Tynogc/24V-to-12V-step-down-15A/webench_design_4079392_15_154593080.pdf

## WEBENCH ® Design Report

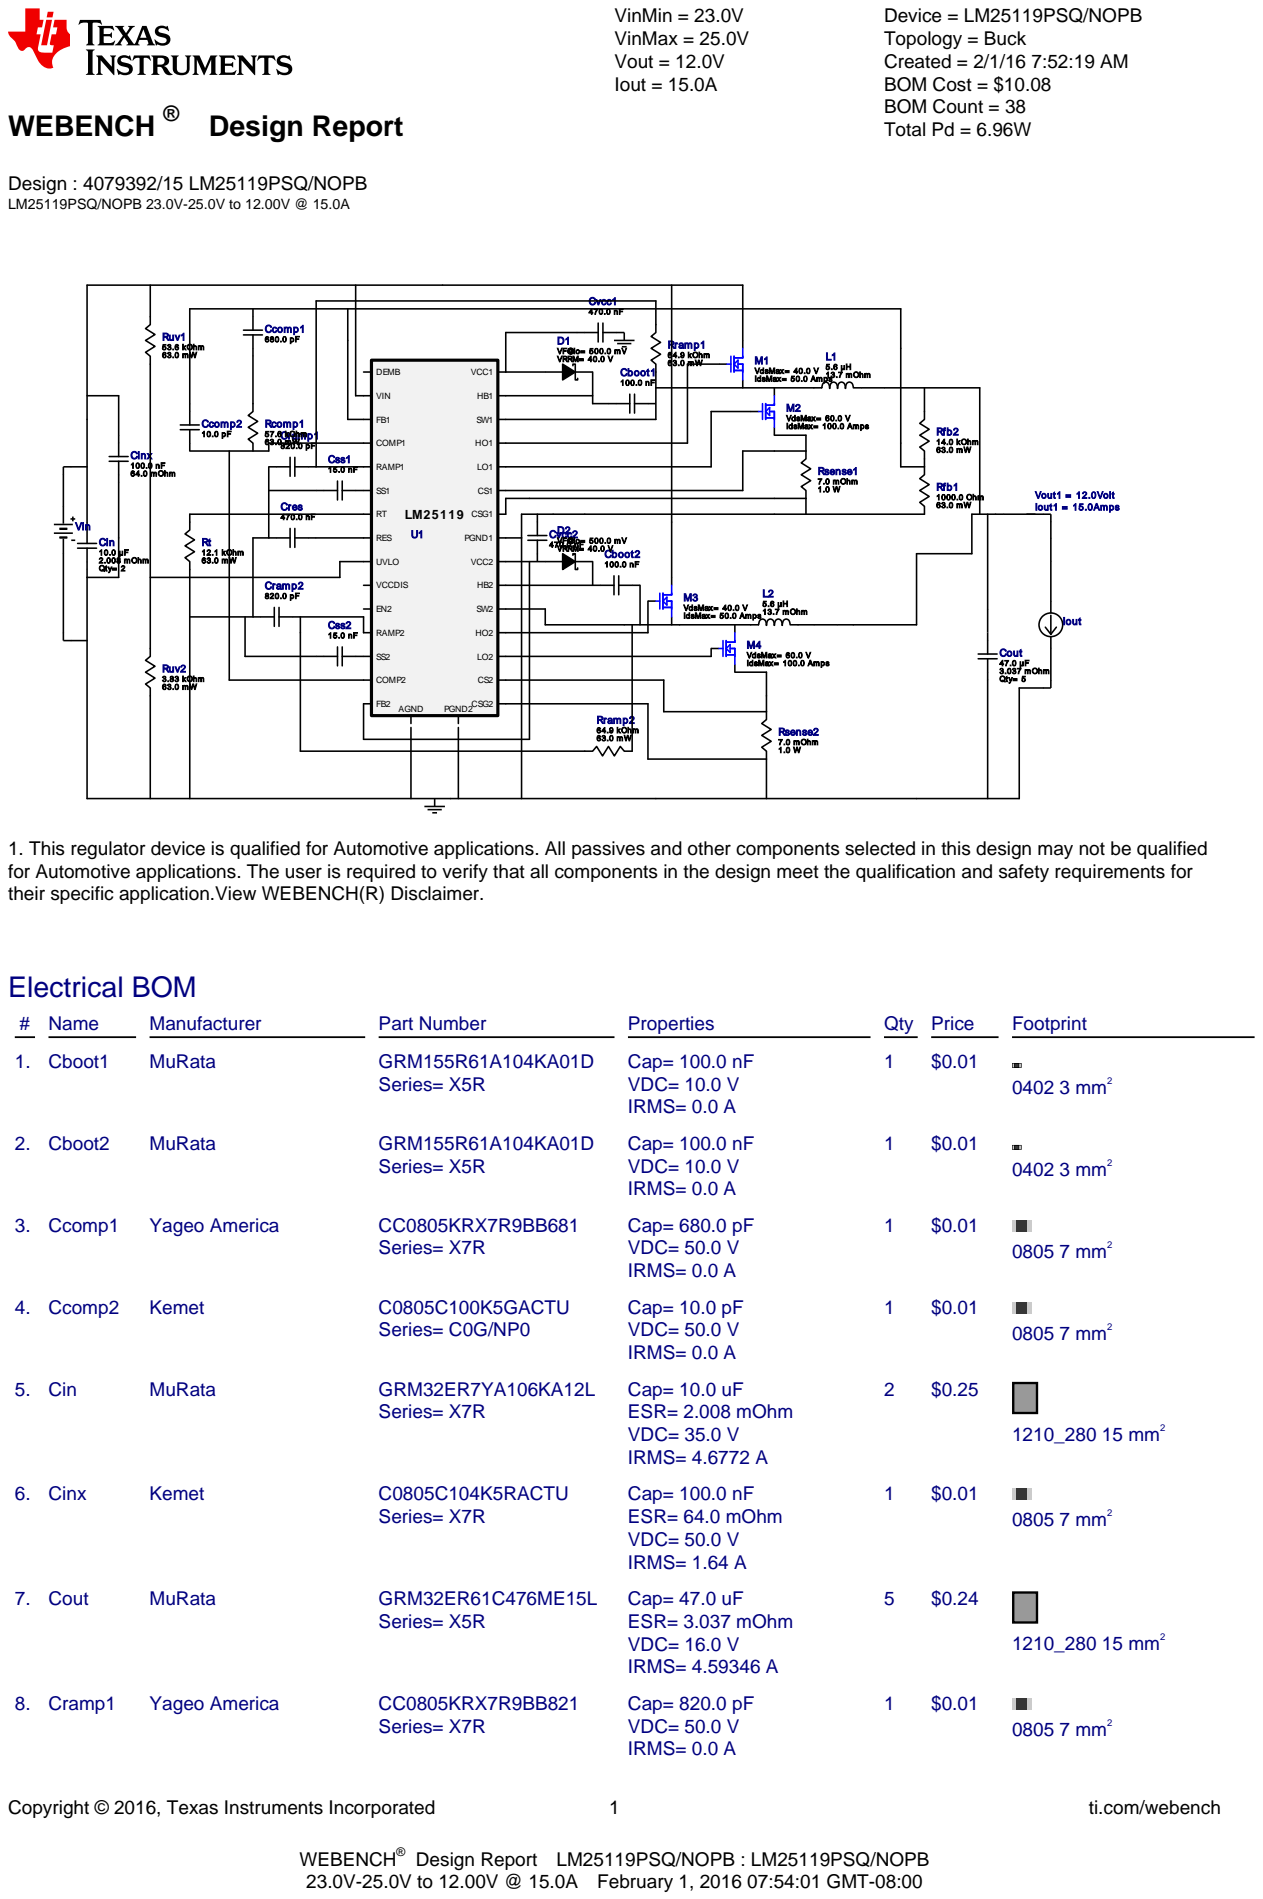
[picture p1: page 1]

1. This regulator device is qualified for Automotive applications. All passives and other components selected in this design may not be qualified
for Automotive applications. The user is required to verify that all components in the design meet the qualification and safety requirements for
their specific application.View WEBENCH(R) Disclaimer.

Design Report LM25119PSQ/NOPB : LM25119PSQ/NOPB

Design

Copyright © 2016, Texas Instruments Incorporated | 2 | ti.com/webench
# Name | Manufacturer | Part Number | Properties | Qty Price | Footprint

9. Cramp2 | Yageo America | CC0805KRX7R9BB821 (http://www.yageo.com/documents/recent/UPY%2DGPHC%5FX7R%5F6.3V%2Dto%2D50V%5F7.pdf) Series= X7R | Cap= 820.0 pF VDC= 50.0 V IRMS= 0.0 A
1 | $0.01
| | | | | 0805 7 mm²
10. Cres | MuRata | GRM155C80J474KE19D (http://search.murata.co.jp/Ceramy/PnsearchViewAction.do) Series= X6S | Cap= 470.0 nF VDC= 6.3 V IRMS= 0.0 A
1 | $0.01
| | | | | 0402 3 mm²
11. Css1 | Yageo America | CC0805KRX7R9BB153 (http://www.yageo.com/documents/recent/UPY%2DGPHC%5FX7R%5F6.3V%2Dto%2D50V%5F7.pdf) Series= X7R | Cap= 15.0 nF VDC= 50.0 V IRMS= 0.0 A
1 | $0.01
| | | | | 0805 7 mm²
12. Css2 | Yageo America | CC0805KRX7R9BB153 (http://www.yageo.com/documents/recent/UPY%2DGPHC%5FX7R%5F6.3V%2Dto%2D50V%5F7.pdf) Series= X7R | Cap= 15.0 nF VDC= 50.0 V IRMS= 0.0 A
1 | $0.01
| | | | | 0805 7 mm²
13. Cvcc1 | MuRata | GRM155R61A474KE15D (http://search.murata.co.jp/Ceramy/PnsearchViewAction.do) Series= X5R | Cap= 470.0 nF VDC= 10.0 V IRMS= 0.0 A
1 | $0.01
| | | | | 0402 3 mm²
14. Cvcc2 | MuRata | GRM155R61A474KE15D (http://search.murata.co.jp/Ceramy/PnsearchViewAction.do) Series= X5R | Cap= 470.0 nF VDC= 10.0 V IRMS= 0.0 A
1 | $0.01
| | | | | 0402 3 mm²
15. D1 | Diodes Inc. | B240A-13-F (http://www.diodes.com/datasheets/ds13004.pdf) | VF@Io= 500.0 mV VRRM= 40.0 V
1 | $0.09
| | | | | SMA 37 mm²
16. D2 | Diodes Inc. | B240A-13-F (http://www.diodes.com/datasheets/ds13004.pdf) | VF@Io= 500.0 mV VRRM= 40.0 V
1 | $0.09
| | | | | SMA 37 mm²
17. L1 | Coilcraft | XAL7070-562MEB (http://www.coilcraft.com/pdfs/xal7070.pdf) | L= 5.6 µH DCR= 13.7 mOhm
1 | $1.05

XAL7070 87 mm²
18. L2 | Coilcraft | XAL7070-562MEB (http://www.coilcraft.com/pdfs/xal7070.pdf) | L= 5.6 µH DCR= 13.7 mOhm
1 | $1.05

XAL7070 87 mm²
19. M1 | Texas Instruments | CSD18504Q5A (http://www.ti.com/lit/ds/symlink/csd18504q5a.pdf) | VdsMax= 40.0 V IdsMax= 50.0 Amps
1 | $0.56

TRANS_NexFET_Q5A 55
mm²
20. M2 | Texas Instruments | CSD18531Q5A (http://www.ti.com/lit/ds/symlink/csd18531q5a.pdf) | VdsMax= 60.0 V IdsMax= 100.0 Amps
1 | $0.90

TRANS_NexFET_Q5A 55
mm²
21. M3 | Texas Instruments | CSD18504Q5A (http://www.ti.com/lit/ds/symlink/csd18504q5a.pdf) | VdsMax= 40.0 V IdsMax= 50.0 Amps
1 | $0.56

TRANS_NexFET_Q5A 55
mm²
22. M4 | Texas Instruments | CSD18531Q5A (http://www.ti.com/lit/ds/symlink/csd18531q5a.pdf) | VdsMax= 60.0 V IdsMax= 100.0 Amps
1 | $0.90

TRANS_NexFET_Q5A 55
mm²
23. Rcomp1 | Vishay-Dale | CRCW040257K6FKED (http://www.vishay.com/docs/20035/dcrcwe3.pdf) Series= CRCW..e3 | Res= 57.6 kOhm Power= 63.0 mW Tolerance= 1.0%
1 | $0.01
0402 3 mm²
24. Rfb1 | Vishay-Dale | CRCW04021K00FKED (http://www.vishay.com/docs/20035/dcrcwe3.pdf) Series= CRCW..e3 | Res= 1000.0 Ohm Power= 63.0 mW Tolerance= 1.0%
1 | $0.01
0402 3 mm²
25. Rfb2 | Vishay-Dale | CRCW040214K0FKED (http://www.vishay.com/docs/20035/dcrcwe3.pdf) Series= CRCW..e3 | Res= 14.0 kOhm Power= 63.0 mW Tolerance= 1.0%
1 | $0.01
0402 3 mm²
26. Rramp1 | Vishay-Dale | CRCW040264K9FKED (http://www.vishay.com/docs/20035/dcrcwe3.pdf) Series= CRCW..e3 | Res= 64.9 kOhm Power= 63.0 mW Tolerance= 1.0%
1 | $0.01
0402 3 mm²

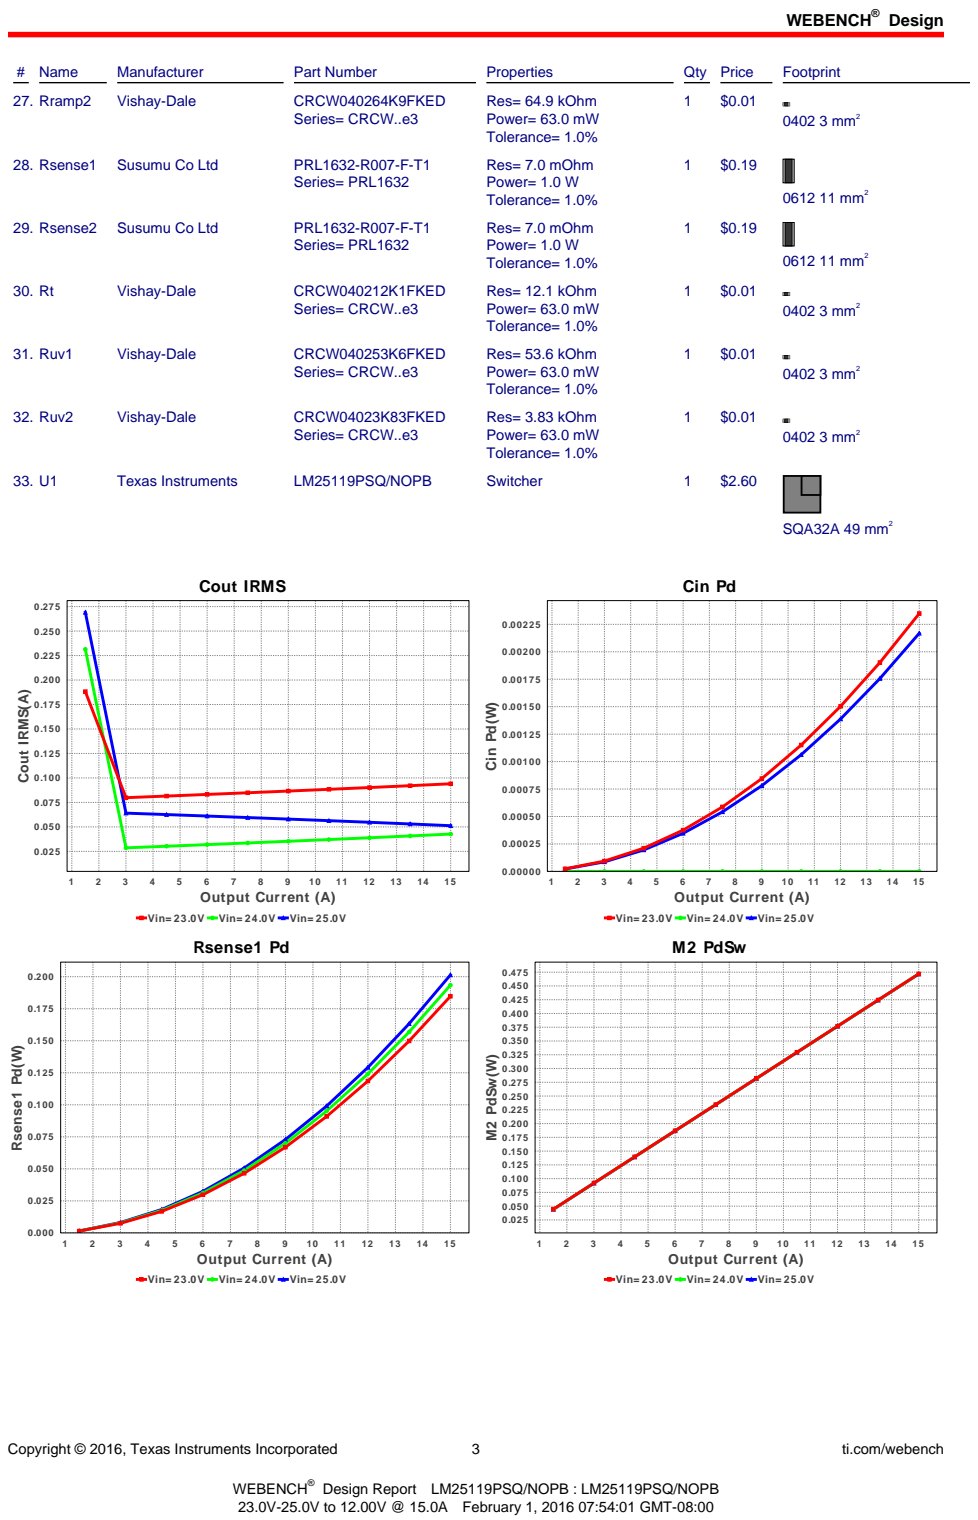
[picture p2: page 3]
Copyright © 2016, Texas Instruments Incorporated; ti.com/webench; # Name; Manufacturer; Part Number; Properties; Qty Price; Footprint; 27. Rramp2; Vishay-Dale; CRCW040264K9FKED; Series= CRCW..e3; Res= 64.9 kOhm Power= 63.0 mW Tolerance= 1.0%; 0402 3 mm²; 28. Rsense1 Susumu Co Ltd; PRL1632-R007-F-T1; Series= PRL1632; Res= 7.0 mOhm Power= 1.0 W Tolerance= 1.0%; 0612 11 mm²; 29. Rsense2 Susumu Co Ltd; CRCW040212K1FKED; Res= 12.1 kOhm Power= 63.0 mW Tolerance= 1.0%; 31. Ruv1; CRCW040253K6FKED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

Vin= 23.0V Vin= 24.0V Vin= 25.0V
Rsense1 Pd

M2 PdSw

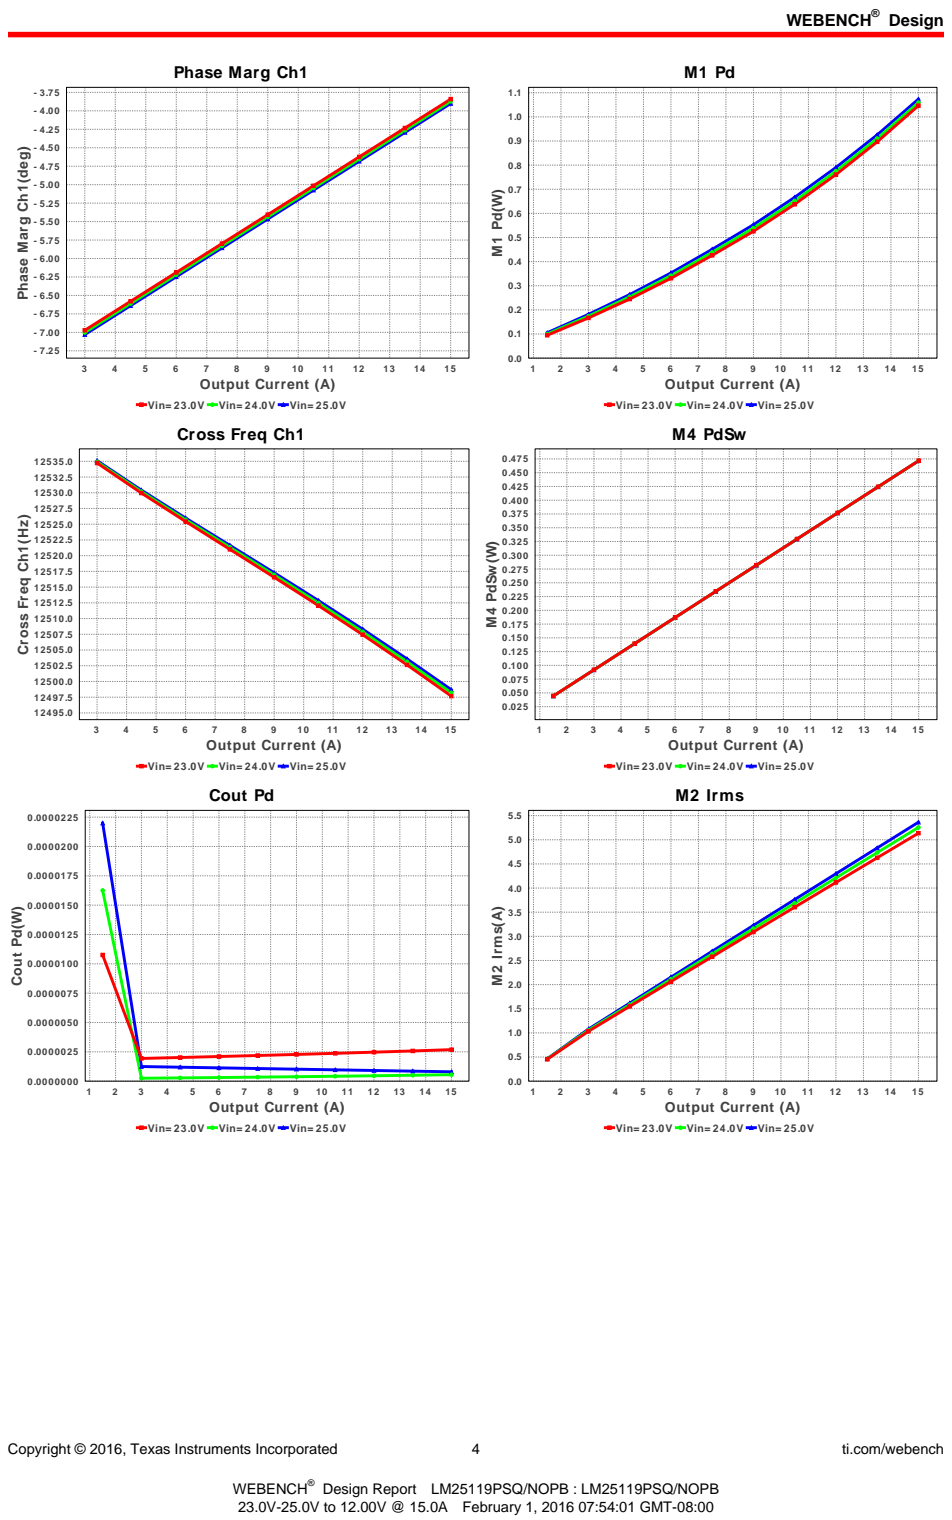
[picture p3: page 4]
Copyright © 2016, Texas Instruments Incorporated; ti.com/webench; Phase Marg Ch1; 15 Output Current (A); M4 PdSw(W); Cout Pd; Cout Pd(W); M2 Irms; M2 Irms(A)

Phase Marg Ch1(deg)

Vin= 23.0V Vin= 24.0V Vin= 25.0V
Cross Freq Ch1

M4 PdSw

Cross Freq Ch1(Hz)

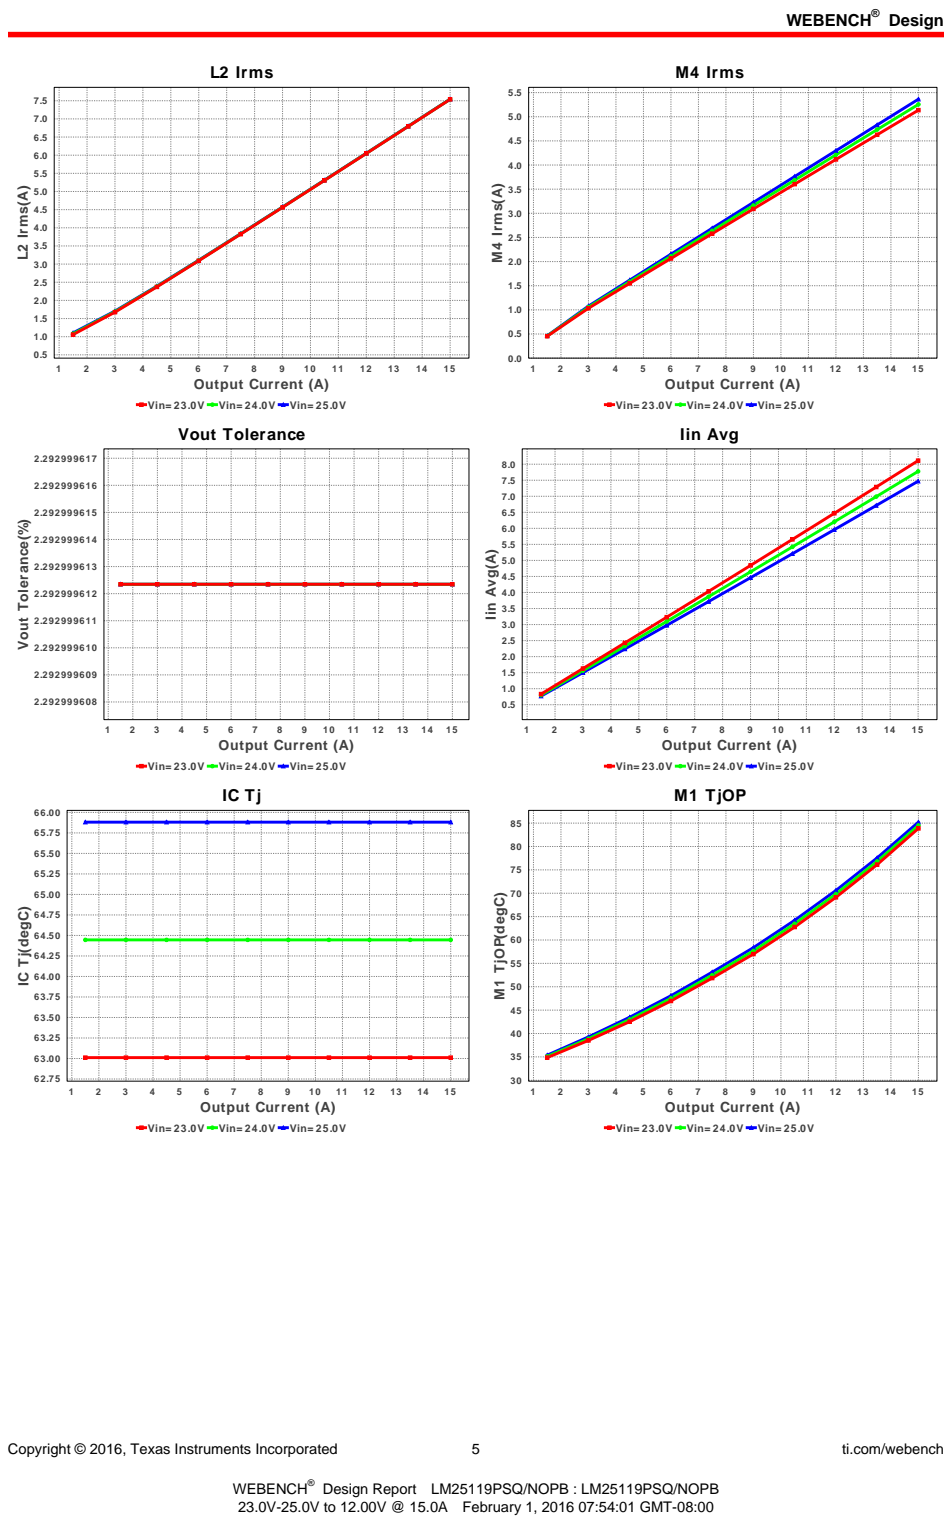
[picture p4: page 5]
Copyright © 2016, Texas Instruments Incorporated; ti.com/webench; L2 Irms; 15 Output Current (A); L2 Irms(A); M4 Irms; M4 Irms(A); 10 11 12 13 14 15 Output Current (A); Vout Tolerance(%); Iin Avg; Iin Avg(A); M1 TjOP; M1 TjOP(degC)

Vin= 23.0V Vin= 24.0V Vin= 25.0V
Vout Tolerance

IC Tj(degC)

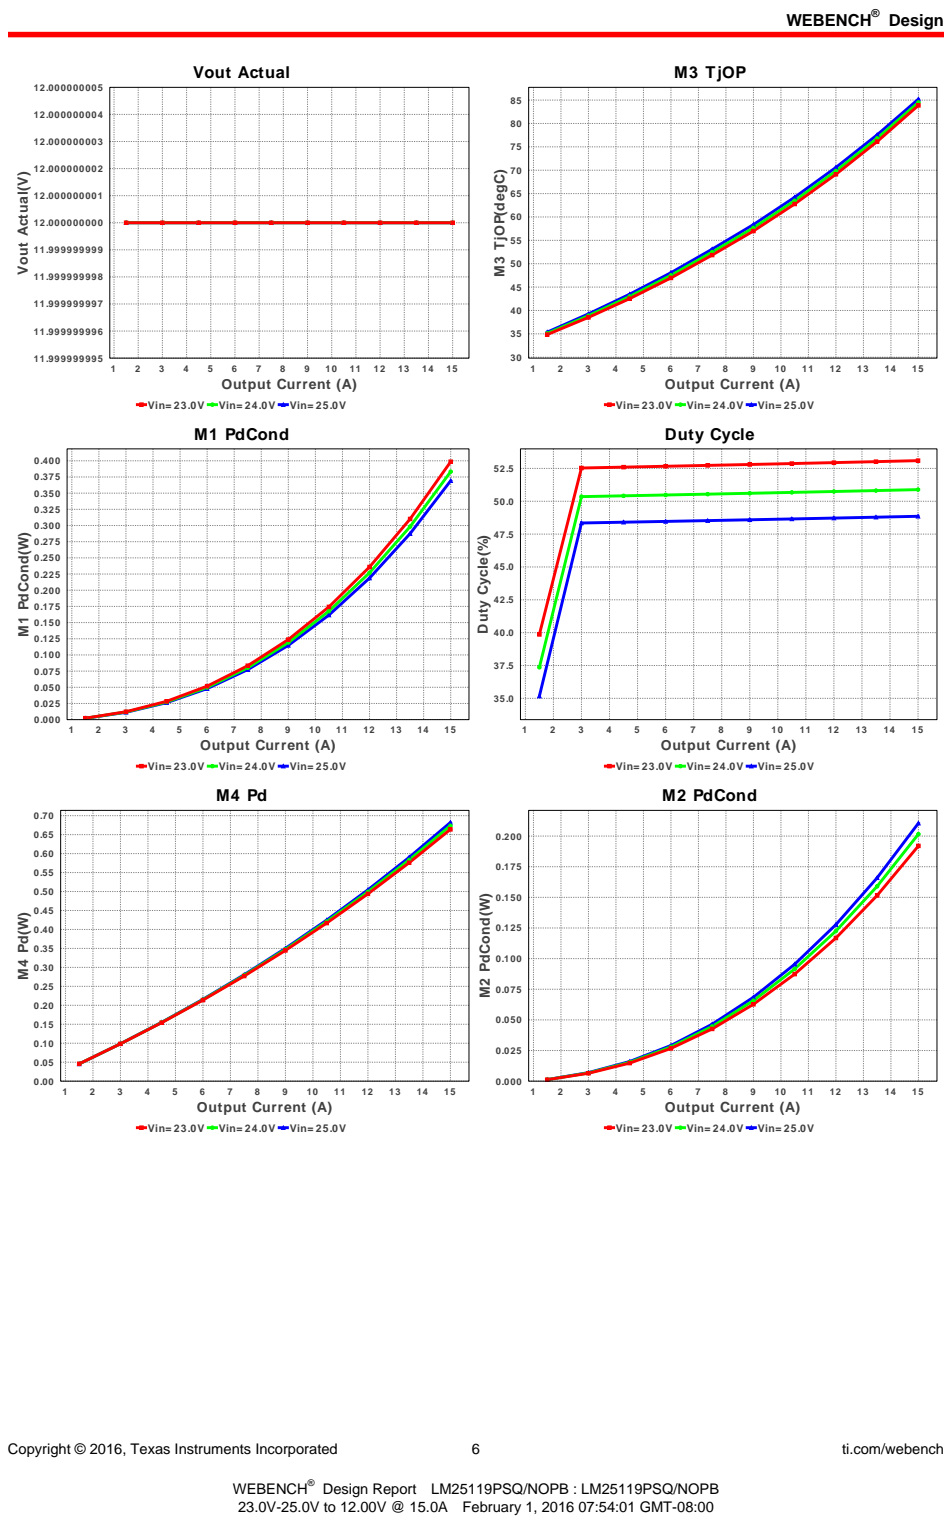
[picture p5: page 6]
Copyright © 2016, Texas Instruments Incorporated; ti.com/webench; Vout Actual; 10 11 12 13 14 15 Output Current (A); Vout Actual(V); M3 TjOP; 15 Output Current (A); M3 TjOP(degC); M1 PdCond(W); Duty Cycle(%); M2 PdCond(W)

Vin= 23.0V Vin= 24.0V Vin= 25.0V
M1 PdCond

Duty Cycle

M2 PdCond

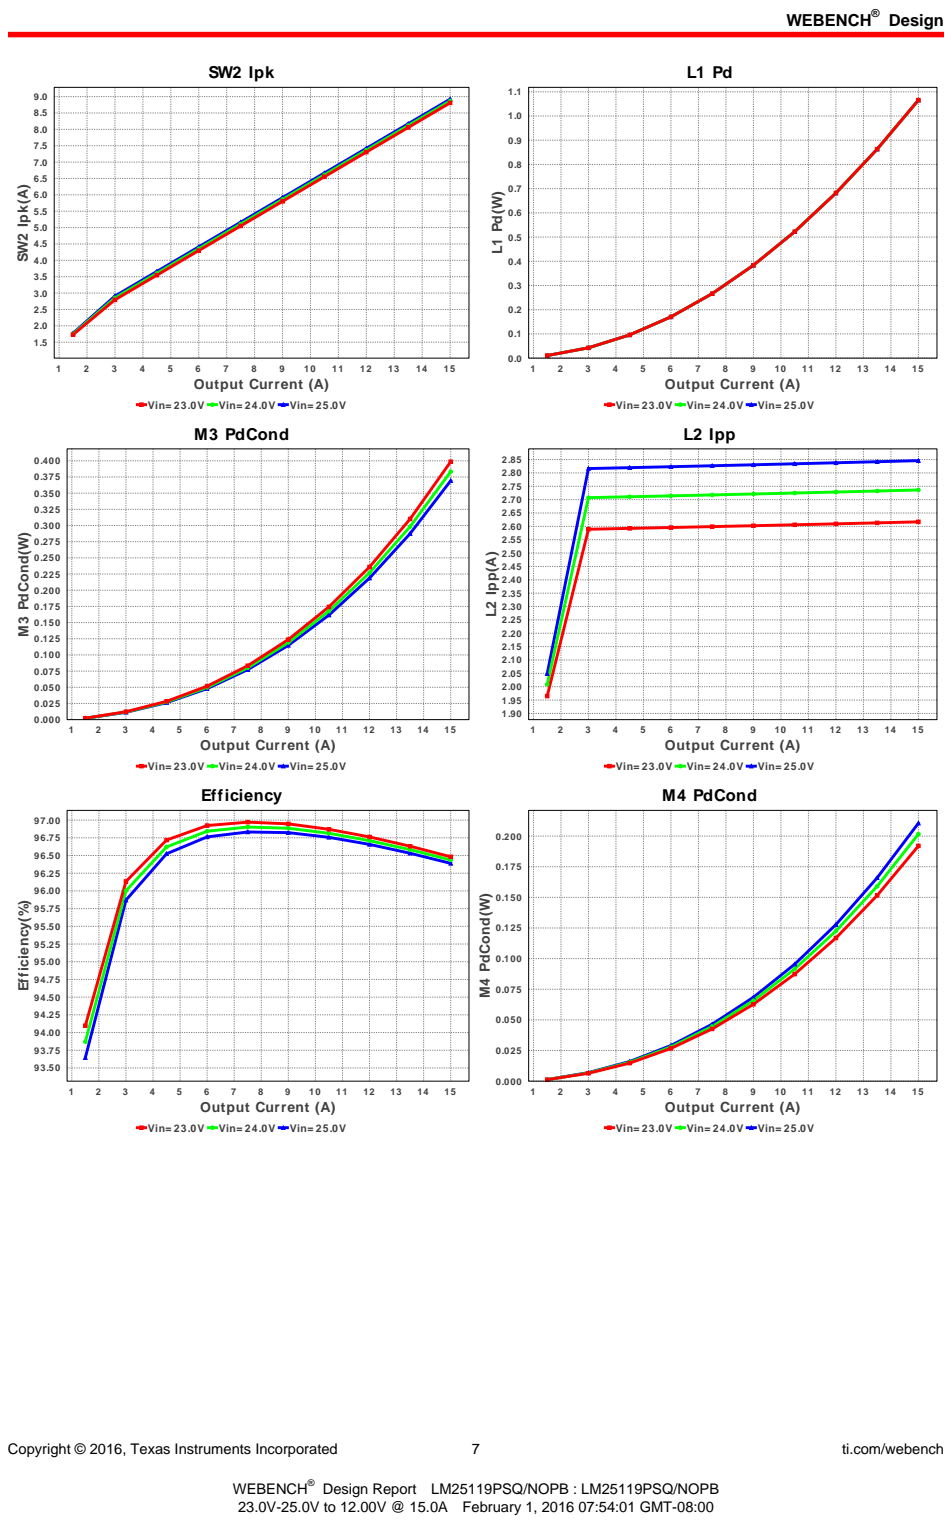
[picture p6: page 7]
Copyright © 2016, Texas Instruments Incorporated; ti.com/webench; SW2 Ipk; 15 Output Current (A); SW2 Ipk(A); M3 PdCond(W); L2 Ipp; L2 Ipp(A); Efficiency(%); M4 PdCond(W)

Vin= 23.0V Vin= 24.0V Vin= 25.0V
M3 PdCond

Efficiency

M4 PdCond

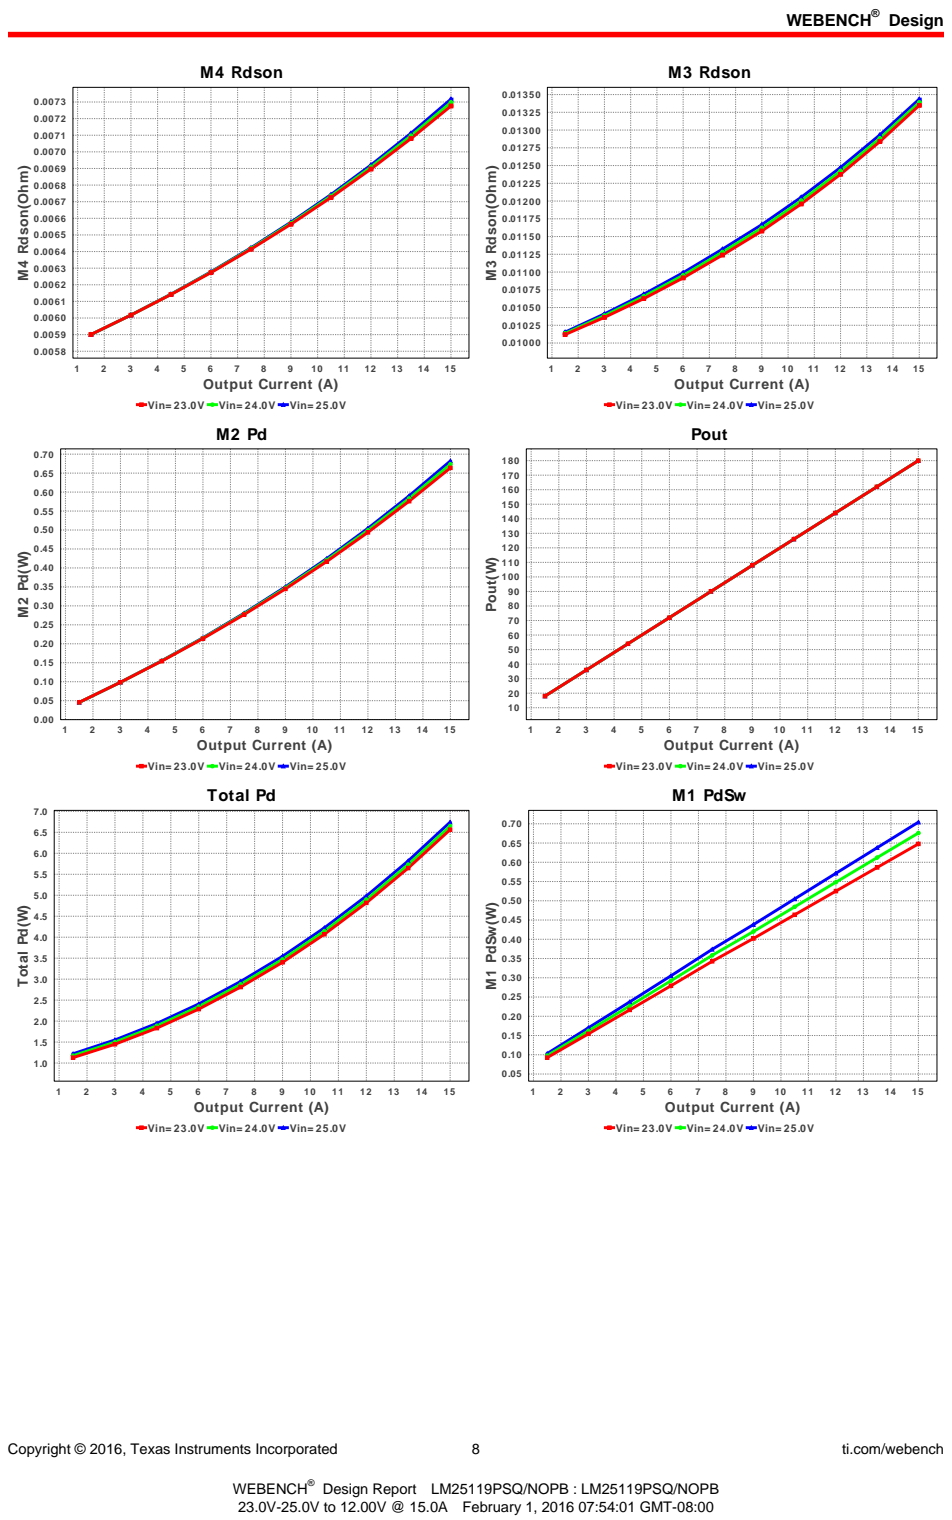
[picture p7: page 8]
Copyright © 2016, Texas Instruments Incorporated; ti.com/webench; M4 Rdson; 15 Output Current (A); M4 Rdson(Ohm); M3 Rdson; M3 Rdson(Ohm); Pout; Pout(W); Total Pd; Total Pd(W); M1 PdSw(W)

Vin= 23.0V Vin= 24.0V Vin= 25.0V

M1 PdSw

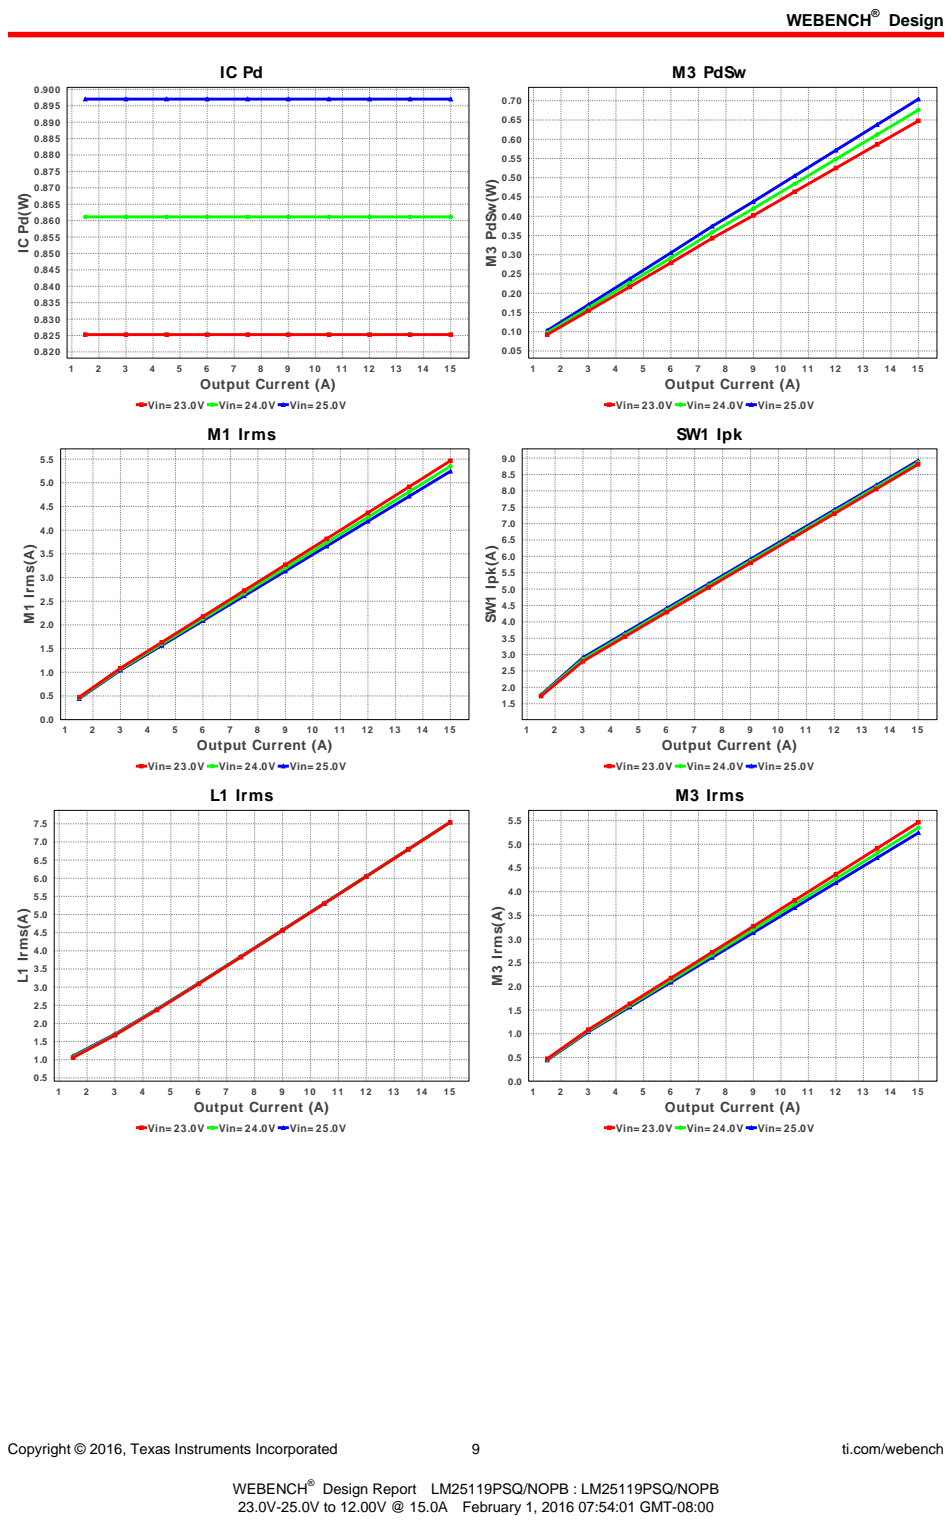
[picture p8: page 9]
Copyright © 2016, Texas Instruments Incorporated; ti.com/webench; 15 Output Current (A); M3 PdSw; M3 PdSw(W); M1 Irms; M1 Irms(A); SW1 Ipk; SW1 Ipk(A); L1 Irms; L1 Irms(A); M3 Irms; M3 Irms(A)

Vin= 23.0V Vin= 24.0V Vin= 25.0V

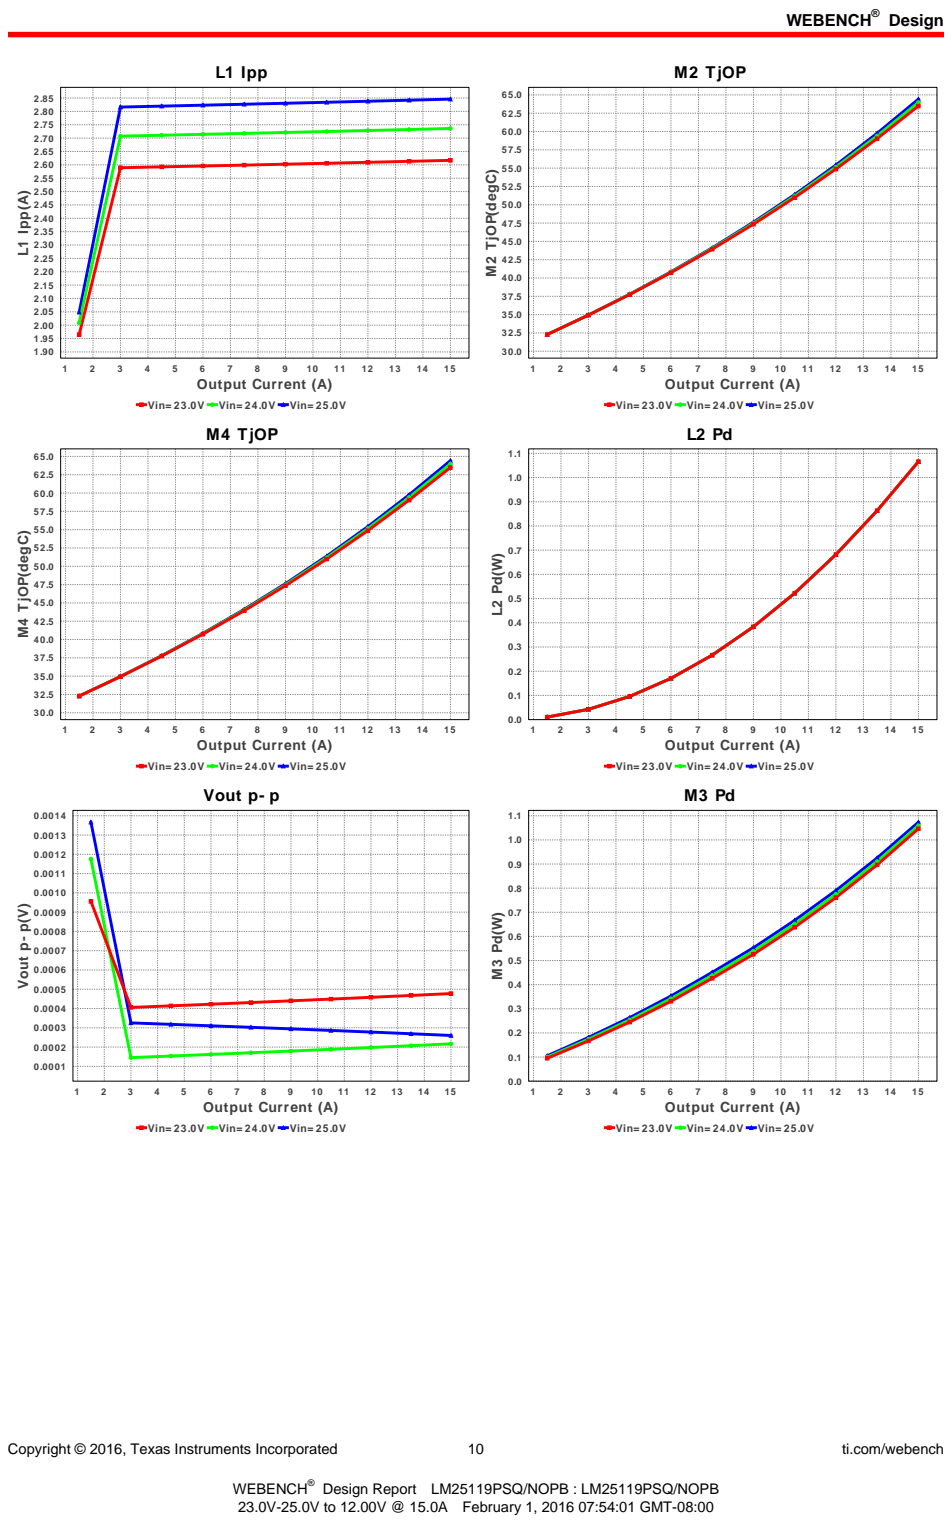
[picture p9: page 10]
Copyright © 2016, Texas Instruments Incorporated; ti.com/webench; L1 Ipp; 15 Output Current (A); L1 Ipp(A); M2 TjOP; M2 TjOP(degC); M4 TjOP; M4 TjOP(degC); Vout p- p(V)

Vin= 23.0V Vin= 24.0V Vin= 25.0V

Vout p- p

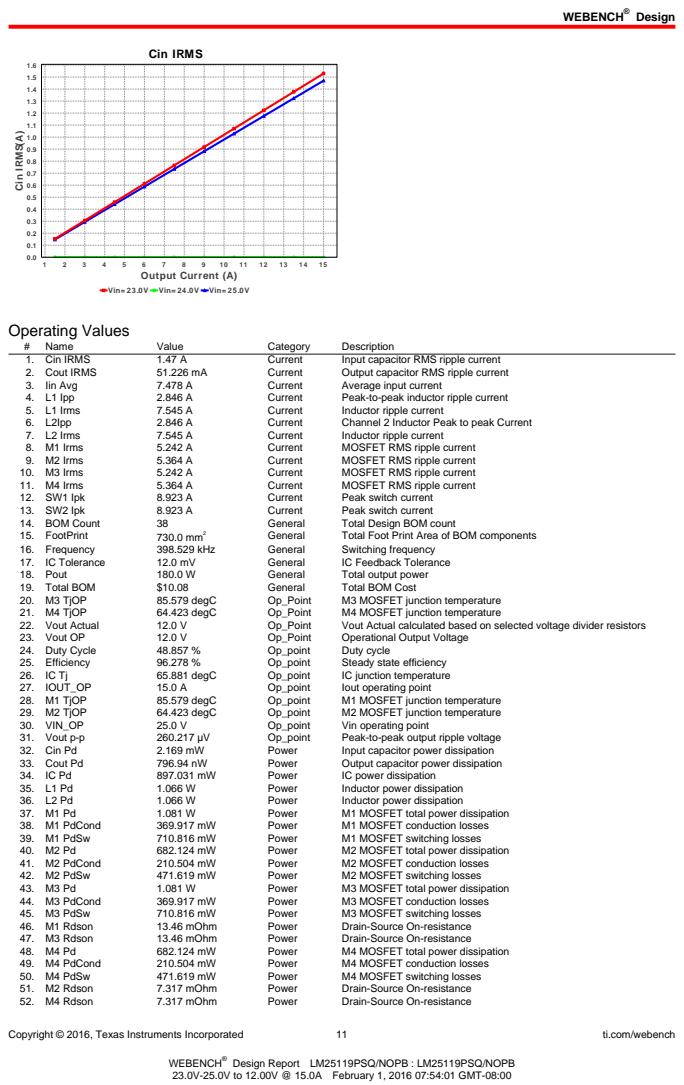
[picture p10: page 11]
Copyright © 2016, Texas Instruments Incorporated; ti.com/webench; Cin IRMS; 15 Output Current (A); Cin IRMS(A); Operating Values; Name; Value; Category; Description; 1. Cin IRMS; Current; Input capacitor RMS ripple current; 2. Cout IRMS; Output capacitor RMS ripple current; 3. Iin Avg; Average input current; 4. L1 Ipp; Peak-to-peak inductor ripple current; 5. L1 Irms; Inductor ripple current; 6. L2Ipp; Channel 2 Inductor Peak to peak Current; 7. L2 Irms; 8. M1 Irms; MOSFET RMS ripple current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

Vin= 23.0V Vin= 24.0V Vin= 25.0V

Copyright © 2016, Texas Instruments Incorporated | 12 | ti.com/webench
# | Name | Value | Category | Description

53. Rsense1 Pd | 201.374 mW | Power | Current Limit Sense Resistor Power Dissipation
54. Rsense2 Pd | 201.374 mW | Power | Current Limit Sense Resistor Power Dissipation
55. Total Pd | 6.959 W | Power | Total Power Dissipation
56. Cross Freq Ch1 | 35.295 kHz | Unknown | Bode plot crossover frequency
57. Phase Marg Ch1 | 52.243 deg | Unknown | Bode Plot Phase Margin
58. Vout Tolerance | 2.293 % | Unknown | Vout Tolerance based on IC Tolerance and voltage divider resistors if
| | | | applicable

## Design Inputs

# | Name | Value | Description

1. Iout | 15.0 | Maximum Output Current
2. VinMax | 25.0 | Maximum input voltage
3. VinMin | 23.0 | Minimum input voltage
4. Vout | 12.0 | Output Voltage
5. base_pn | LM25119 | Base Product Number
6. source | DC | Input Source Type
7. Ta | 30.0 | Ambient temperature

## Design Assistance

1. Outline The LM5119 is a dual synchronous buck controller intended for step-down regulator applications from a high voltage or widely varying input supply. The control method is based upon current mode control utilizing an emulated current ramp. Current mode control provides inherent line feed-forward, cycle-by-cycle current limiting and ease of loop compensation. The use of an emulated control ramp reduces noise sensitivity of the pulse-width modulation circuit, allowing reliable control of very small duty cycles necessary in high input voltage applications. Interleaved Operation Interleaved operation can offer many advantages in single output, high current applications. The output power path is split between two identical channels reducing the current in each channel by one-half. Ripple current reduction in the output capacitors is reduced significantly since each channel operates 180 degrees out of phase from the other. Diode Emulation A fully synchronous buck regulator implemented with a freewheel MOSFET rather than a diode has the capability to sink current from the output in certain conditions such as light load, over-voltage or pre-bias startup. The LM(2)5119 provides a diode emulation feature that can be enabled to prevent reverse (drain to source) current flow in the low side free-wheel MOSFET.
2. LM25119 Product Folder : http://www.ti.com/product/LM25119 : contains the data sheet and other resources.

Texas Instruments' WEBENCH simulation tools attempt to recreate the performance of a substantially equivalent physical implementation
of the design. Simulations are created using Texas Instruments' published specifications as well as the published specifications of other device manufacturers. While Texas Instruments does update this information periodically, this information may not be current at the time the simulation is built. Texas Instruments does not warrant the accuracy or completeness of the specifications or any information contained therein. Texas Instruments does not warrant that any designs or recommended parts will meet the specifications you entered, will be suitable for your application or fit for any particular purpose, or will operate as shown in the simulation in a physical implementation. Texas Instruments does not warrant that the designs are production worthy.
You should completely validate and test your design implementation to confirm the system functionality for your application prior to production.
Use of Texas Instruments' WEBENCH simulation tools is subject to Texas Instruments' Site Terms and Conditions of Use. (http://www.ti.com/corp/docs/legal/termsofuse.shtml) Prototype boards based on WEBENCH created designs are provided AS IS without warranty of any kind for evaluation and testing purposes and are subject to the terms of the Evaluation License Agreement. (http://www.ti.com/corp/docs/legal/termsofuse_estore.shtml)
