Tynogc/24V-to-12V-step-down-15A/stepDown.kicad_pcb

## KiCad design stepDown.kicad_pcb (2016-02-04)

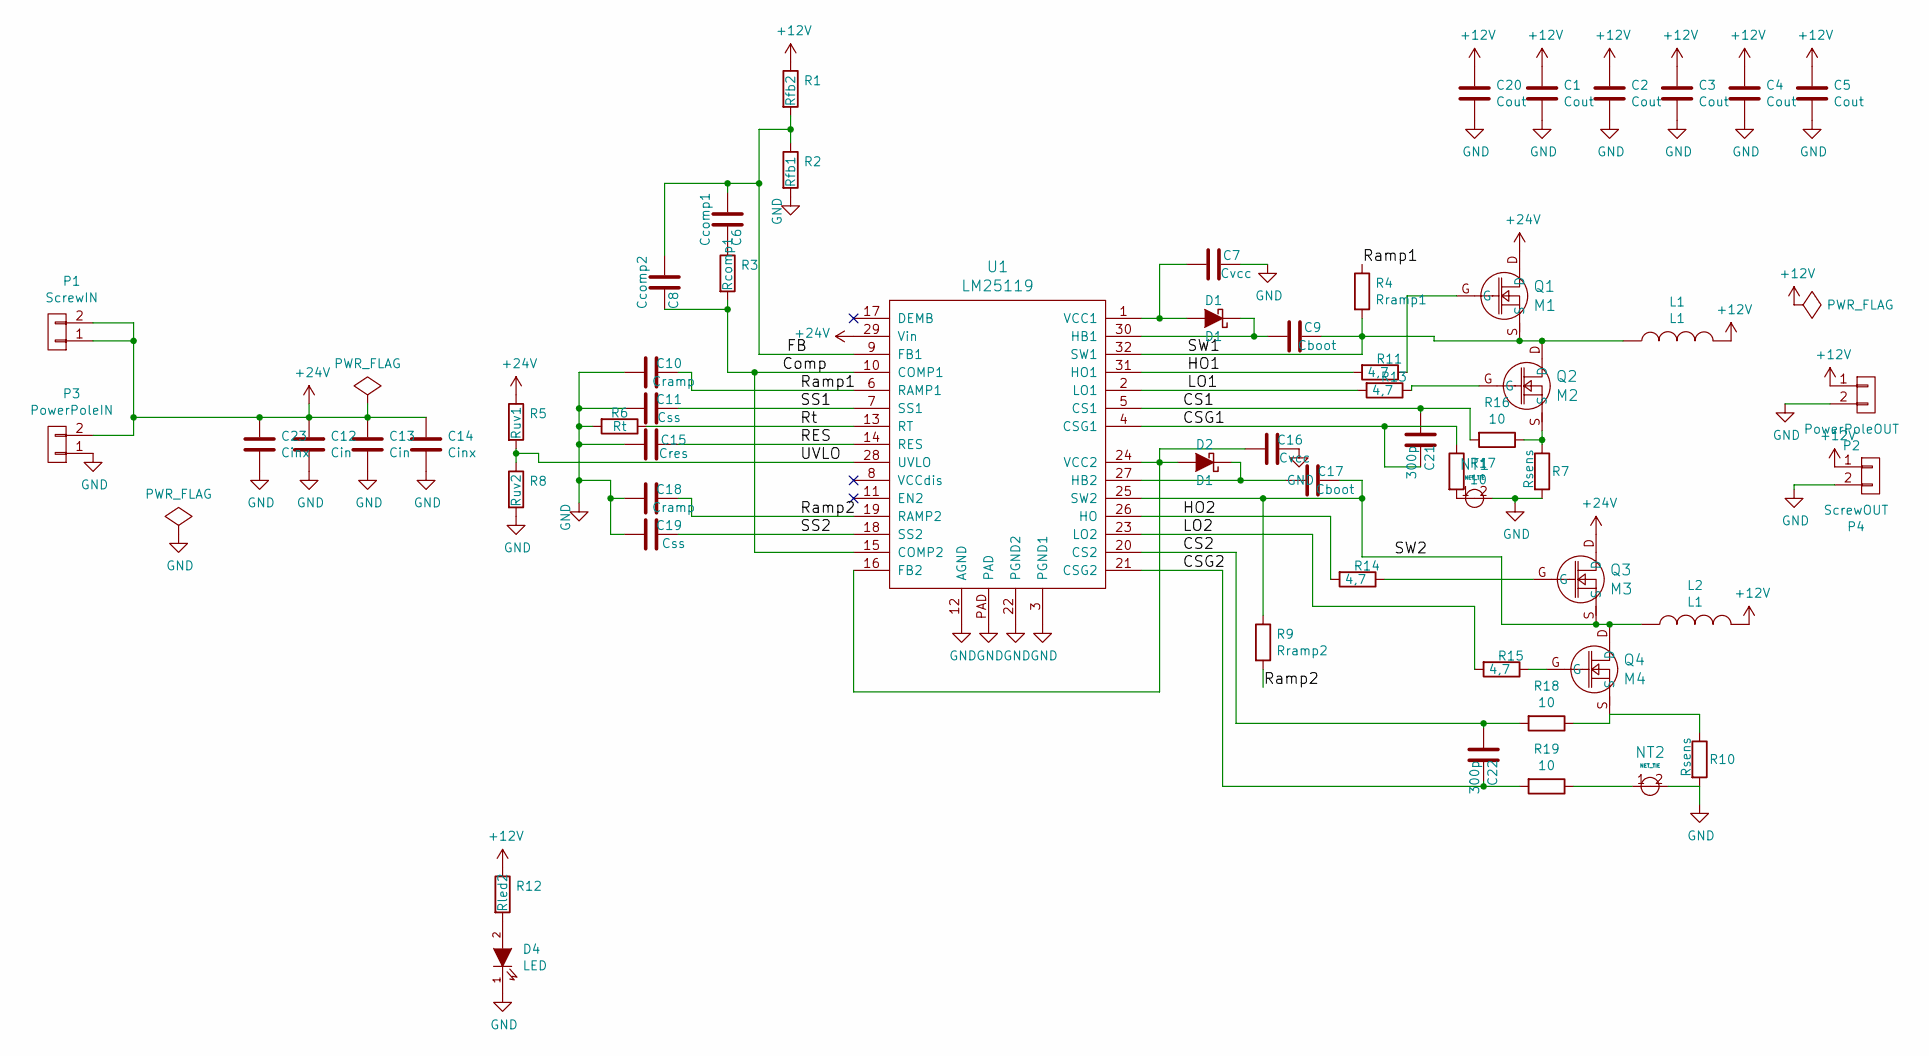
[picture p11: schematic stepDown.sch]

Parts:
C1, C2, C3, C4, C5, C20: Cout; C_1210
C6: Ccomp1; C_0805
C7, C16: Cvcc; C_0603
C8: Ccomp2; C_0805
C9, C17: Cboot; C_0603
C10, C18: Cramp; C_0805
C11, C19: Css; C_0805
C12, C13: Cin; C_1210
C14, C23: Cinx; C_0805
C15: Cres; C_0603
C21, C22: 300p; C_0402
D1, D2: D1; SMA_Standard
D4: LED; LED-3MM
L1, L2: L1; Z_Coilcraft_XAL7070
NT1, NT2: NET_TIE
P1: ScrewIN; Screw_Connector_5,08mm_x2
P2: PowerPoleOUT; PowerPole_1x2
P3: PowerPoleIN; PowerPole_1x2
P4: ScrewOUT; Screw_Connector_5,08mm_x2
Q1: M1; SO8_WITH_Heatpipes_New
Q2: M2; SO8_WITH_Heatpipes_New
Q3: M3; SO8_WITH_Heatpipes_New
Q4: M4; SO8_WITH_Heatpipes_New
R1: Rfb2; R_0603
R2: Rfb1; R_0603
R3: Rcomp1; R_0603
R4: Rramp1; R_0603
R5: Ruv1; R_0603
R6: Rt; R_0603
R7, R10: Rsens; R_1218
R8: Ruv2; R_0603
R9: Rramp2; R_0603
R11, R13, R14, R15: 4,7; R_0603
R12: Rled2; R_0603
R16, R17, R18, R19: 10; R_0603
U1: LM25119; WQFN32_PAD

Connections:
+12V: C1.1, C2.1, C3.1, C4.1, C5.1, C20.1, L1.2, L2.2, P2.1, P4.1, R1.1, R12.1
+24V: C12.1, C13.1, C14.1, C23.1, P1.1, P1.2, P3.2, Q1.D, Q3.D, R5.1, U1.29 (Vin)
/CS1: C21.2, R16.2, U1.5 (CS1)
/CS2: C22.2, R18.2, U1.20 (CS2)
/CSG1: C21.1, R17.1, U1.4 (CSG1)
/CSG2: C22.1, R19.2, U1.21 (CSG2)
/Comp: C8.1, R3.2, U1.10 (COMP1), U1.15 (COMP2)
/FB: C6.2, C8.2, R1.2, R2.1, U1.9 (FB1)
/HO1: R11.2, U1.31 (HO1)
/HO2: R14.2, U1.26 (HO)
/LO1: R13.2, U1.2 (LO1)
/LO2: R15.2, U1.23 (LO2)
/RES: C15.1, U1.14 (RES)
/Ramp1: C10.1, R4.1, U1.6 (RAMP1)
/Ramp2: C18.1, R9.2, U1.19 (RAMP2)
/Rt: R6.1, U1.13 (RT)
/SS1: C11.1, U1.7 (SS1)
/SS2: C19.1, U1.18 (SS2)
/SW1: C9.1, L1.1, Q1.S, Q2.D, R4.2, U1.32 (SW1)
/SW2: C17.1, L2.1, Q3.S, Q4.D, R9.1, U1.25 (SW2)
/UVLO: R5.2, R8.1, U1.28 (UVLO)
GND: C1.2, C2.2, C3.2, C4.2, C5.2, C7.1, C10.2, C11.2, C12.2, C13.2, C14.2, C15.2, C16.1, C18.2, C19.2, C20.2, C23.2, D4.1 (K), NT1.2, NT2.2, P2.2, P3.1, P4.2, R2.2, R6.2, R7.2, R8.2, R10.2, U1.3 (PGND1), U1.12 (AGND), U1.22 (PGND2), U1.PAD
unnamed: C6.1, R3.1
unnamed: C7.2, D1.2 (A), U1.1 (VCC1)
unnamed: C9.2, D1.1 (K), U1.30 (HB1)
unnamed: C16.2, D2.2 (A), U1.16 (FB2), U1.24 (VCC2)
unnamed: C17.2, D2.1 (K), U1.27 (HB2)
unnamed: D4.2 (A), R12.2
unnamed: NT1.1, R17.2
unnamed: NT2.1, R19.1
unnamed: Q1.G, R11.1
unnamed: Q2.G, R13.1
unnamed: Q2.S, R7.1, R16.1
unnamed: Q3.G, R14.1
unnamed: Q4.G, R15.1
unnamed: Q4.S, R10.1, R18.1

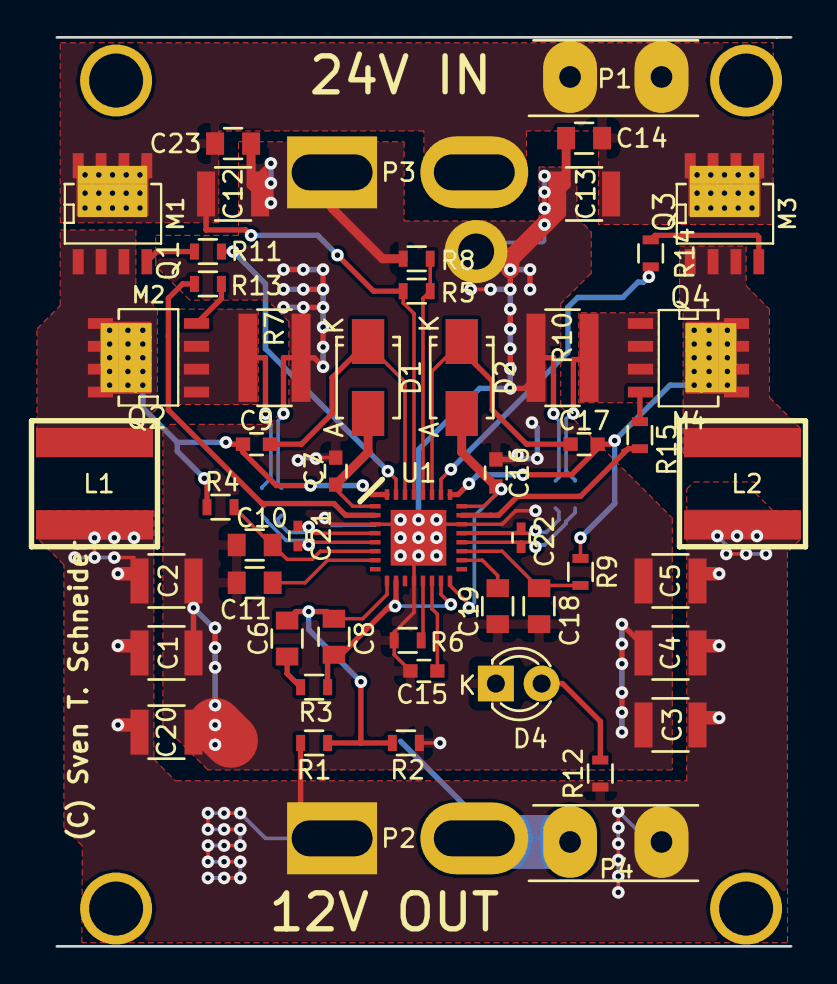
[picture p12: board stepDown.kicad_pcb from above]

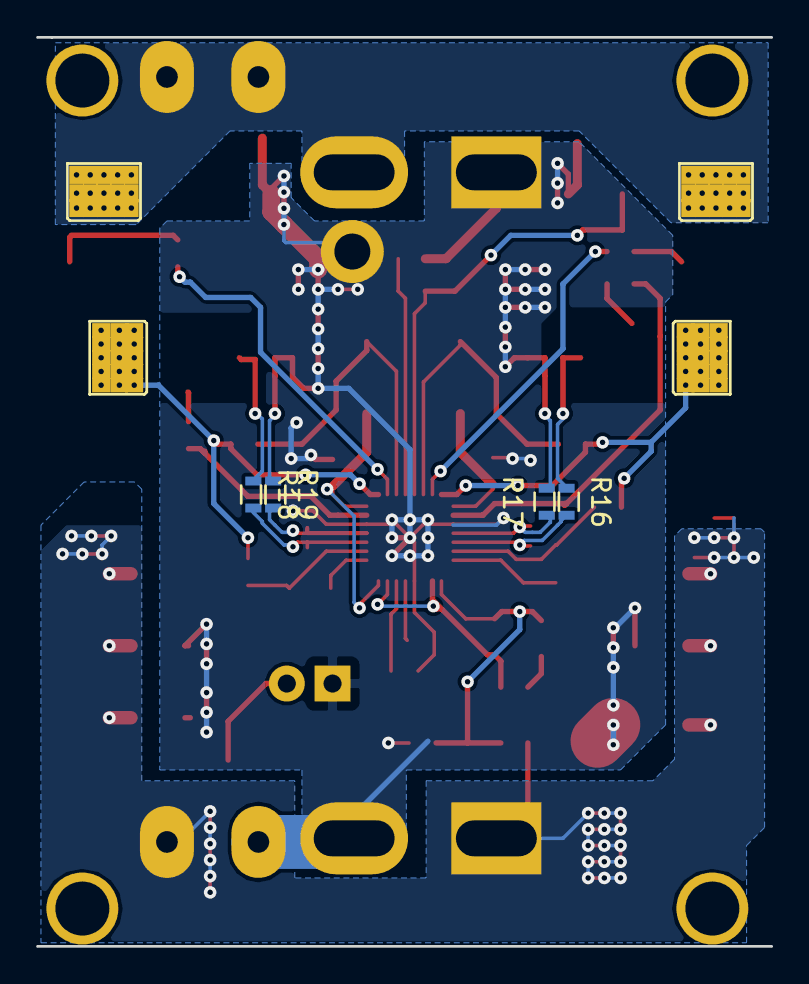
[picture p13: board stepDown.kicad_pcb from below]

Board: 2 copper layers, 40.8 x 50.5 mm, 58 parts (4 on the bottom side), 36 nets.
